snehaprasad11/SignSense/PROJECT_REPORT.pdf

# SignSense: Real-Time Sign Language Word Recognition on an ESP32 Using a Single IMU and TinyML

A wearable that recognises six sign-language words from hand motion and turns them into text and speech. One MPU6500/MPU6050 motion sensor sits on the back of the hand; an ESP32 microcontroller runs a 1-D convolutional neural network with TensorFlow Lite Micro, entirely on the device.

Words: HELLO · THANK YOU · YES · PLEASE · HELP · COME (+ rest)

Result | Value
Accuracy on held-out recordings | 94.92 % (224 / 236 windows)
Accuracy in live use on the ESP32 | 80.77 % (42 / 52 prompted trials)
On-device inference time | 279 ms per Invoke()
Model size | 437 KB float32 · 120 KB INT8 (same accuracy)
Hardware | ESP32-D0WD-V3 (no PSRAM) + MPU6500

This report follows the review presentation outline; each section maps to one or more slides.

## 1. Motivation 1 slide

Most hearing people do not know sign language, so deaf and hard-of-hearing signers often depend on an interpreter for everyday conversations.
Camera-based translators need good lighting, a clear view of the hands, a powerful computer and a camera pointed at the user, which raises privacy concerns.
Sensor gloves avoid the camera but usually need many sensors (one per finger) and a PC. Goal: a low-cost wearable that recognises common sign words on a ₹-level microcontroller, without a camera, a cloud connection or a PC doing the recognition.

SignSense project report · page 1 of 20

## 2. Contemporary works — literature survey 2 slides

# | Work | Approach | Strength | Limitation for our goal

[1] Camgöz et al., CVPR | 2020 | Video + Transformer (continuous SL translation) | Full sentences, high accuracy | Needs camera and GPU
[2] Wu, Sun & Jafari, IEEE | JBHI 2016 | Wrist IMU + surface EMG, 80 ASL signs | Real-time, wearable | Two sensor types; classification on a PC
[3] Zhou et al., Nature | Electronics 2020 | Stretchable yarn strain sensors on each finger, sign-to-speech | 660 ASL hand gestures, wireless | Custom fabricated sensors; recognition on a phone or PC
[4] Wen et al., Nature | Communications 2021 | Triboelectric smart glove + deep learning | Words and sentences | Many custom sensors; off-device processing
[5] Ahmed et al., Sensors | 2018 (review) | Survey of sensory gloves 2007–2017 | Shows the field's reliance on multi-sensor gloves | Few low-cost, on-device systems
[6] Ordóñez & Roggen, | Sensors 2016 | CNN + LSTM on wearable IMU data | Shows CNNs learn motion features from raw IMU data | Activity recognition, not sign language; not embedded
[7] David et al., MLSys 2021 | (TF Lite Micro) | Inference framework for microcontrollers | Neural networks in kilobytes of RAM | Framework only
[8] Banbury et al., 2020 | (TinyML benchmarking) | Benchmarks for ML on microcontrollers | Shows latency/memory limits of MCU ML | Not a sign-language system
[9] techmiguel/gesture- | recognition (GitHub) | ESP32-S3 + MPU6050 + Conv1D, 5 direction gestures | Fully on-device; our starting code base | Directions only; needs PSRAM; no live-accuracy study

Research gap and objective 1 slide

Gap

1. Camera systems need a camera, a GPU and a clear line of sight.
2. Glove systems use many sensors (one per finger) and send data to a PC or phone for recognition.
3. Few systems recognise sign words with one IMU and do the recognition entirely on a low-cost microcontroller, especially one without external PSRAM.
4. Most papers report only offline test accuracy. They rarely measure how accuracy changes when a person signs live, on prompt.

Objectives

1. Recognise 6 sign words + rest from a single back-of-hand IMU.
2. Run the complete model on a classic ESP32 (no PSRAM) with TensorFlow Lite Micro.
3. Reach ≥ 90 % accuracy on held-out data and measure live accuracy separately.
4. Measure on-device latency and memory, and compare float32 vs INT8 and Flatten vs GAP models.
5. Show the recognised word as text and speech on a laptop.

## 3. Proposed methodology — block diagram 1 slide

System block diagram (what runs at demo time)

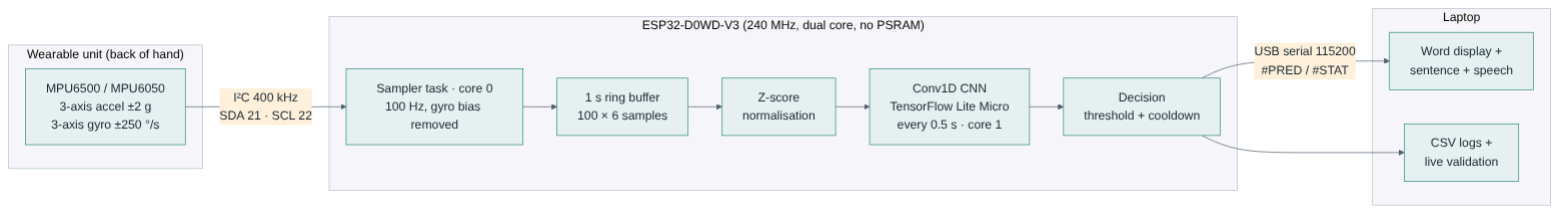
[picture p9: figure]

Development workflow (how the model was built; numbers = team roles, Section 11)

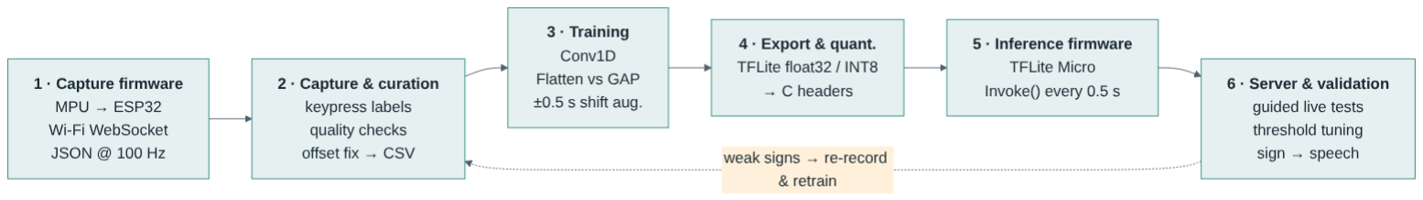
[picture p10: figure]

The dotted arrow shows the iteration loop used in this project: live testing found weak signs, which were re-recorded and retrained.

### 4. Sub-systems 1 slide, headings only

1. Sensing & capture firmware: MPU6500 driver, 100 Hz sampling, Wi-Fi streaming
2. Data capture & dataset curation: labelling, quality checks, offset correction, balancing
3. Model training: Conv1D network, augmentation, architecture comparison
4. Model export & quantization: TFLite float32 / INT8, C-array generation
5. On-device inference firmware: TFLite Micro, dual-core scheduling, decision logic
6. Inference server & system validation: live display, speech, guided tests, threshold tuning

Supporting diagrams:

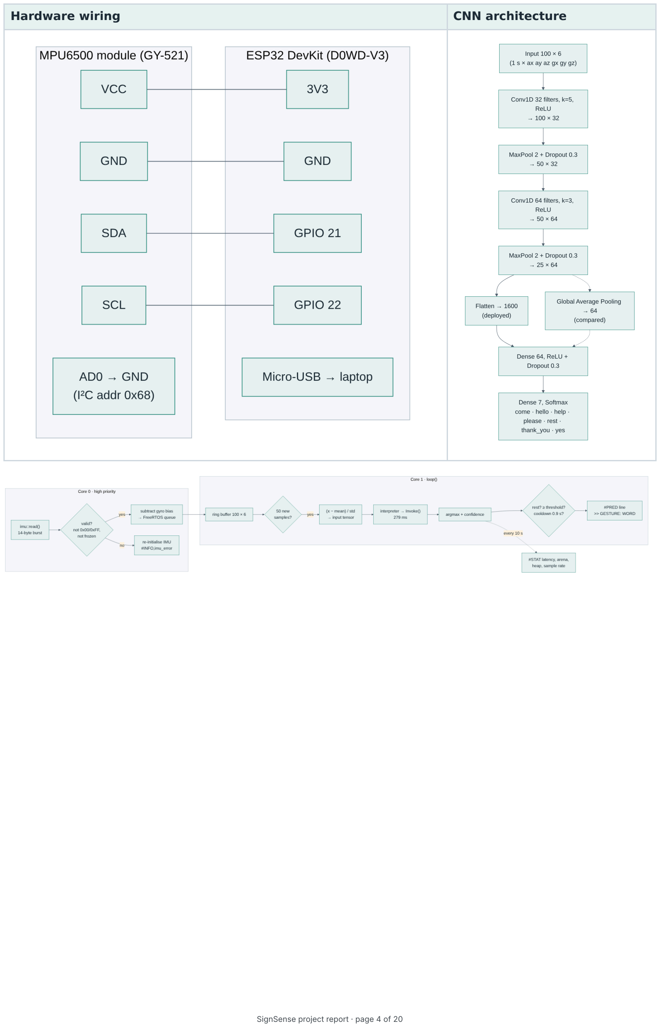
[picture p11: page 4]

Hardware wiring | CNN architecture

## 5. Database and performance metrics 1 slide

Dataset (self-recorded)

Item | Value
Sensor | MPU6500 (WHO_AM_I = 0x70), back of right hand
Channels | ax, ay, az (g, ±2 g) · gx, gy, gz (°/s, ±250 °/s)
Sampling | 100 Hz, digital low-pass ≈ 42 Hz
Sample (window) | 1 s = 100 timesteps × 6 axes = 600 values
Labelling | key press right after each sign; 3 time-shifted windows per press in the final round
Quality checks | Wi-Fi gaps, timing, saturation, "sign with no motion", "rest that moves", gyro offset
Classes | come, hello, help, please, rest, thank_you, yes
Clean windows | come 150 · hello 149 · help 191 · please 149 · rest 157 · thank_you 191 · yes 191 = 1,178
Split (stratified, seed 42) | train 800 · validation 142 · test 236
Training set after augmentation | 5,600 (6 extra copies: ±0.5 s time shift, noise, ±10 % scale)
Earlier dataset (direction gestures) | up / down / left / right / rest, 730 windows

Performance metrics

Metric | Formula
Accuracy | Σ TP / N
Precision | TP / (TP + FP)
Recall | TP / (TP + FN)
F1 score | 2PR / (P + R)
Cohen's κ | (p_o − p_e) / (1 − p_e)
95 % CI | Wilson score interval
Live trial accuracy | correct trials / prompted trials (guided test)
Latency, memory | measured on device: Invoke() µs, tensor-arena bytes, free heap

## 6. Results 3 slides

Results 1: Classification accuracy

| Test set (N = 236 windows) | Live on ESP32 (N = 52 trials)
Accuracy | 94.92 % (95 % CI 91.3–97.1) | 80.77 % (95 % CI 68.1–89.2)
Macro F1 | 95.11 % | 80.02 %
Cohen's κ | 0.941 | 0.776
Chance level | 14.3 % | 14.3 %

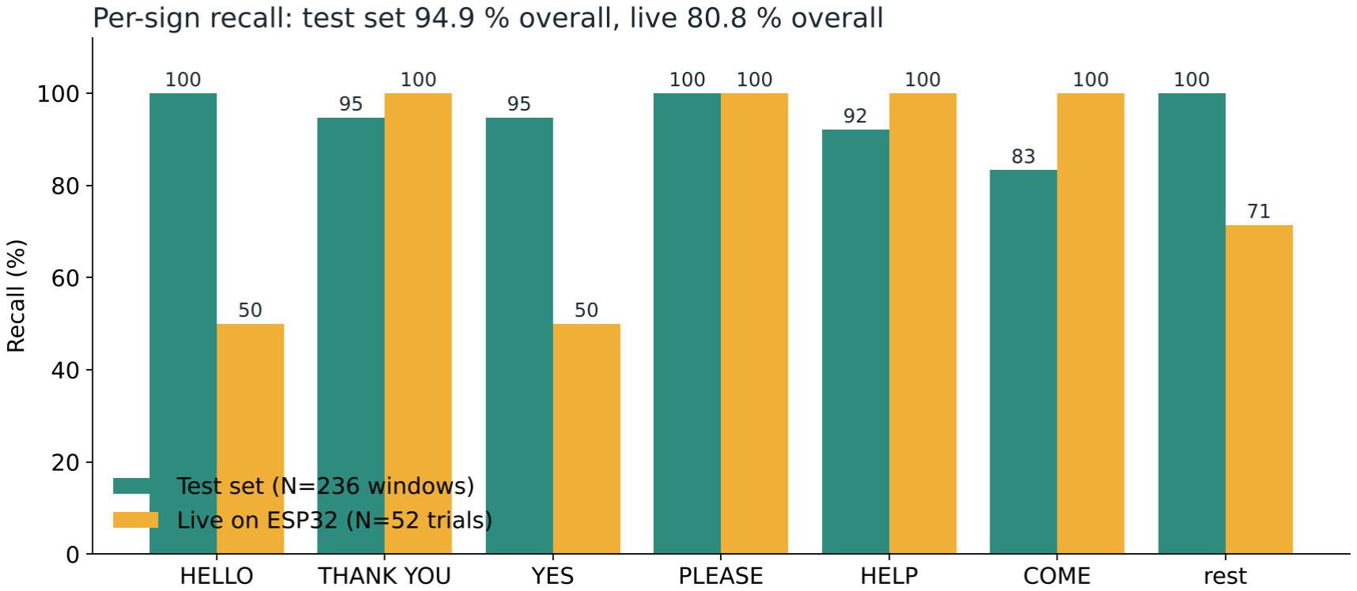
[picture p12: figure]

Test-set confusion matrix (rows = true, columns = predicted):

| come | hello | help | please | rest | thank_you | yes
come | 25 | 0 | 0 | 0 | 0 | 0 | 5
hello | 0 | 30 | 0 | 0 | 0 | 0 | 0
help | 0 | 0 | 35 | 0 | 0 | 2 | 1
please | 0 | 0 | 0 | 30 | 0 | 0 | 0
rest | 0 | 0 | 0 | 0 | 32 | 0 | 0
thank_you | 0 | 0 | 2 | 0 | 0 | 36 | 0
yes | 2 | 0 | 0 | 0 | 0 | 0 | 36

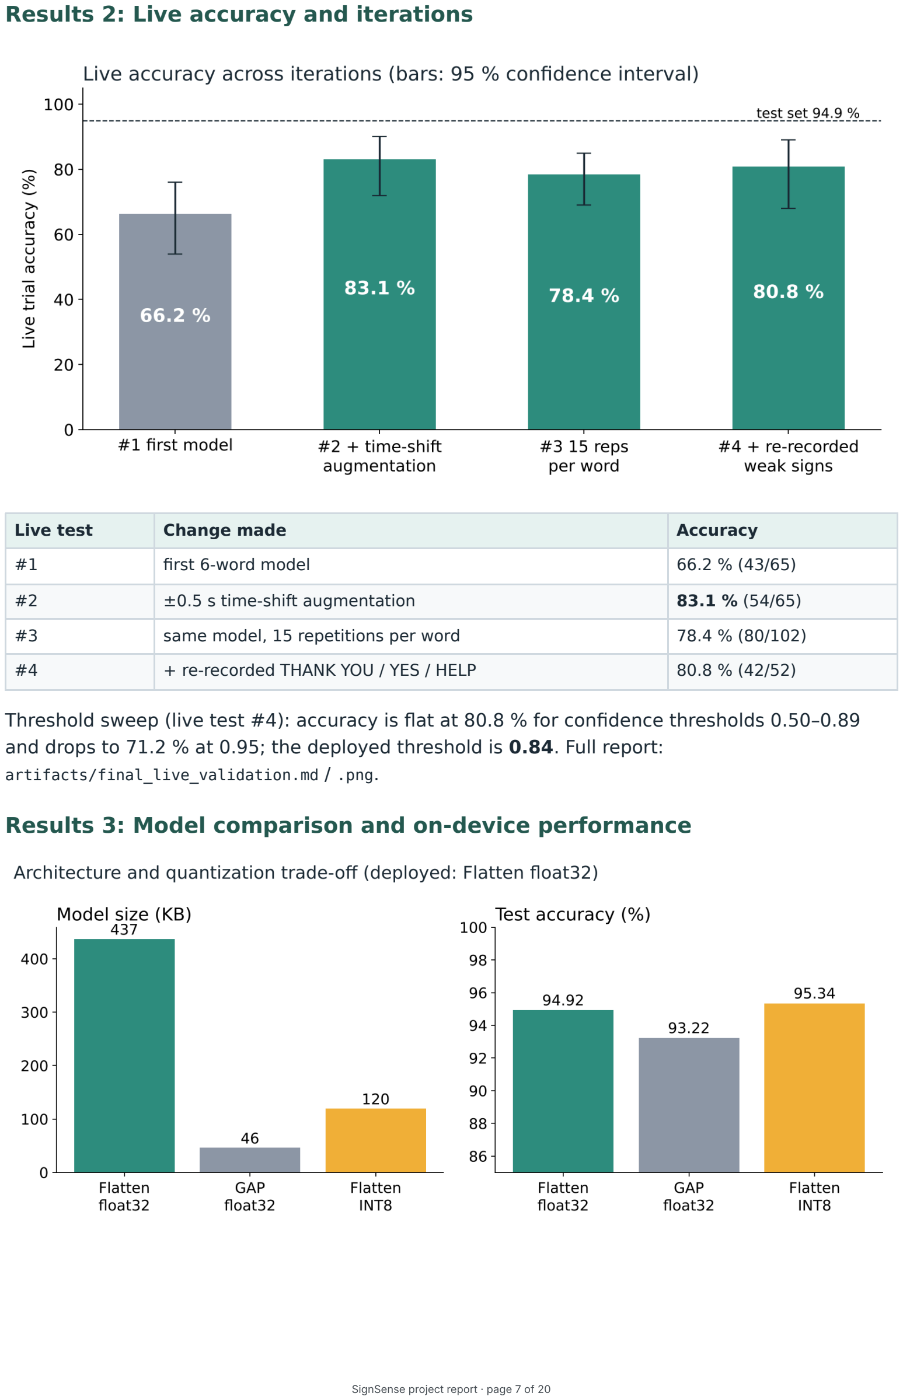
[picture p13: page 7]

Results 2: Live accuracy and iterations

Live test | Change made | Accuracy
#1 | first 6-word model | 66.2 % (43/65)

#2 | ±0.5 s time-shift augmentation | 83.1 % (54/65)

#3 | same model, 15 repetitions per word | 78.4 % (80/102)

#4 | + re-recorded THANK YOU / YES / HELP | 80.8 % (42/52)

Threshold sweep (live test #4): accuracy is flat at 80.8 % for confidence thresholds 0.50–0.89 and drops to 71.2 % at 0.95; the deployed threshold is 0.84. Full report:
artifacts/final_live_validation.md / .png.

Results 3: Model comparison and on-device performance

Model | Test accuracy | Parameters | Size
Conv1D + Flatten, float32 (deployed) | 94.92 % | 110,119 | 437.1 KB
Conv1D + Global Average Pooling | 93.22 % | 11,815 | 46.2 KB
Conv1D + Flatten, INT8 | 95.34 % (99.58 % agreement with float32) | 110,119 | 119.6 KB
On-device (ESP32-D0WD-V3, 240 MHz) | Value
Invoke() latency | 279.1 ms (min 279.08 · max 279.25)
Pre-processing | 0.22 ms
CPU load at 1 inference / 0.5 s | 55.8 % of one core
Sampling | 99.9 Hz, 0 samples lost
Tensor arena | 28 KB (internal RAM, no PSRAM)
Free heap at runtime | 186 KB
Flash used | 856 KB (27 %)
End of sign → word shown | ≈ 0.28–0.78 s

## 7. Discussion 1 slide

Offline vs live gap (94.9 % → 80.8 %). The test set comes from the same recording sessions as training. Live signs vary more in speed, size and timing. The largest single improvement, 66 % → 83 %, came from time-shift augmentation. In the recordings every sign ended at the window's end, but the device classifies every 0.5 s, so live signs appear anywhere in the window.
Weak signs. YES (a small fist nod) starts like COME and THANK YOU. HELLO (a repeated wave) can look like PLEASE's circular motion. With one sensor these differ only in small motion details. Signs with large, distinct movements (COME, HELP, PLEASE, THANK YOU) reach 100 % live.
Flatten vs GAP. GAP was better for direction gestures (99.3 % vs 98.0 %) but worse for signs (93.2 % vs 94.9 %). Averaging over time throws away when motion happens, and that timing is what separates COME from YES.
INT8 quantization cut size 3.65× with no accuracy loss. This leaves room for more classes or a larger model on the same chip.
Hardware findings. The "MPU6050" module was an MPU6500 clone (WHO_AM_I 0x70) and was rejected by the standard library, so a register-level driver was written. A gyro calibration taken while the board was moving shifted the first dataset by ≈ 50 °/s. Curation now detects and removes this, and the firmware refuses to calibrate while moving.
Threshold. Higher thresholds cut false triggers but miss weak signs; 0.84 balanced both.

## 8. Novelty and future scope 1 slide

Novelty

1. Sign-word recognition with one IMU and the complete CNN running on a classic ESP32 without PSRAM (28 KB tensor arena in internal RAM).

2. Live, prompted validation with per-iteration accuracy, confidence intervals and a threshold sweep, in addition to offline accuracy.
3. Time-shift augmentation matched to the inference stride, which raised live accuracy from 66 % to 83 % without new recordings.
4. Robust low-cost hardware handling: clone-sensor driver, motion-gated gyro calibration, automatic offset correction, and recovery from a loose sensor wire without a reboot.
5. Fully reproducible pipeline: model_config.h (normalisation, classes, quantization) is generated automatically, so the firmware and the training code always match.

Future scope

Record training data in the same prompted way as live use, aiming for ≥ 90 % live accuracy. Add finger flex sensors to recognise handshapes and the alphabet.
Deploy the INT8 model with ESP-NN optimised kernels to cut latency below 100 ms. Bluetooth Low Energy output to a phone app instead of a USB cable.
More signers and more words; continuous sentence recognition with a sequence model. Browser dashboard (live word, sentence, confidences, device health).

## 9. Conclusion 1 slide

A single-IMU wearable with an ESP32 recognises six sign words plus rest entirely on the device: 94.9 % accuracy on held-out data, 80.8 % in live prompted use, and 279 ms inference using 28 KB of RAM on a microcontroller without PSRAM. Time-shift augmentation was the key step for real-world use. Signs with distinct movements are recognised reliably, while signs with very small motions (YES, HELLO) need more training data recorded under live conditions, or additional sensors.

## 10. References 1 slide

1. N. C. Camgöz, O. Koller, S. Hadfield, R. Bowden, "Sign Language Transformers: Joint End-to-End Sign Language Recognition and Translation," Proc. IEEE/CVF CVPR, 2020.
2. J. Wu, L. Sun, R. Jafari, "A Wearable System for Recognizing American Sign Language in Real-Time Using IMU and Surface EMG Sensors," IEEE J. Biomed. Health Inform., vol. 20, no. 5, 2016.
3. Z. Zhou et al., "Sign-to-speech translation using machine-learning-assisted stretchable sensor arrays," Nature Electronics, vol. 3, 2020.
4. F. Wen, Z. Zhang, T. He, C. Lee, "AI enabled sign language recognition and VR space bidirectional communication using triboelectric smart glove," Nature Communications, vol. 12, 2021.
5. M. A. Ahmed, B. B. Zaidan, A. A. Zaidan, M. M. Salih, M. M. Lakulu, "A Review on Systems-Based Sensory Gloves for Sign Language Recognition State of the Art between 2007 and 2017," Sensors, vol. 18, no. 7, 2018.
6. F. J. Ordóñez, D. Roggen, "Deep Convolutional and LSTM Recurrent Neural Networks for Multimodal Wearable Activity Recognition," Sensors, vol. 16, no. 1, 2016.
7. R. David et al., "TensorFlow Lite Micro: Embedded Machine Learning for TinyML Systems," Proc. MLSys, 2021.
8. C. Banbury et al., "Benchmarking TinyML Systems: Challenges and Direction," arXiv:2003.04821, 2020.
9. B. Jacob et al., "Quantization and Training of Neural Networks for Efficient Integer-Arithmetic-Only Inference," Proc. IEEE/CVF CVPR, 2018.
10. M. Lin, Q. Chen, S. Yan, "Network In Network," Proc. ICLR, 2014 (global average pooling).
11. P. Warden, D. Situnayake, TinyML, O'Reilly Media, 2019.
12. techmiguel, "gesture-recognition: ESP32-S3 + MPU6050 + TFLite Micro," GitHub repository, https://github.com/techmiguel/gesture-recognition.
13. InvenSense, MPU-6500 Product Specification and Register Map, rev. 1.x.

## 11. Individual roles 1 slide

# | Sub-system / files | Member | Key contribution (one line for the slide)

1 | Capture firmware: esp32s3_capture.ino, imu.h | Nitigya Khaneja | Register-level MPU6500 driver, 100 Hz fixed-rate sampling, JSON over Wi-Fi WebSocket, motion-gated gyro calibration
2 | Data capture & curation: capture_server.py, curate_dataset.py | Yashita Shrivastava | 1,178 labelled windows (7 classes); automatic quality checks, gyro-offset correction and balancing
3 | Model training: train.py | Sneha Prasad | Conv1D pipeline, Flatten vs GAP comparison, ±0.5 s time-shift augmentation → 94.9 % test accuracy
4 | Export & quantization: export_model.py | Arshiya Agarwal | Float32 (437 KB) and INT8 (120 KB, 95.3 %) TFLite models; auto-generated C headers
5 | Inference firmware: esp32s3_inference.ino | Anusha Ghose | TFLite Micro on a no-PSRAM ESP32 (28 KB arena), dual-core sampling, library fixes, Invoke() = 279 ms
6 | Inference server & validation: inference_server.py, analyze_live.py | Abhilash Sarma | Sign → text/speech, guided live tests, confusion analysis, threshold tuning (0.84) → 80.8 % live

How the six roles connect:

Nitigya | Yashita | Sneha | Arshiya | Anusha | Abhilash
Capture | ──► Capture & | ──► Model | ──► Export & | ──► Inference | ──► Inference server
firmware | curation | training | quantization | firmware | & validation
(sensor → | (labelled, | (Conv1D, | (TFLite, | (TFLite Micro | (words, speech,
Wi-Fi JSON) | clean CSVs) | reports) | C headers) | on ESP32) | live accuracy)
▲ | │
└──────────────── live testing found weak signs → re-record → retrain ───────────────┘

Changes from the original plan (role slide). The plan assumed an ESP32-S3 with PSRAM, 5 direction gestures and a fixed 0.90 threshold. The team's board is a classic ESP32 (ESP32-D0WD-V3) without PSRAM, the sensor is an MPU6500 clone, and the final system recognises 6 sign words + rest, with the threshold tuned to 0.84 from live tests. The descriptions below reflect what was actually built. An updated slide text is at the end.

### 11.1. Capture firmware: Nitigya Khaneja

Files: firmware/esp32s3_capture/esp32s3_capture.ino, imu.h, secrets.h.template

Job: read the motion sensor at exactly 100 Hz and stream every sample to the laptop for recording.

MPU6500 ──I²C 400 kHz──► ESP32 ──fixed 10 ms schedule──► JSON ──Wi-Fi WebSocket :8765──► laptop
SDA 21 / SCL 22 | (gyro bias removed) | {"seq","timestamp_us","ax".."gz","temp_c"}

What was built

Register-level IMU driver (imu.h). The module sold as an "MPU6050" is actually an MPU6500 (WHO_AM_I = 0x70 instead of 0x68), and the standard library rejected it. The driver accepts the MPU6050/6500/9250 family and configures each one identically: ±2 g, ±250 °/s, ≈ 42 Hz low-pass, plus the extra accelerometer filter register that only the 6500 has.
Pins for the classic ESP32. GPIO 8/9 (from the ESP32-S3 plan) are flash pins on this chip; moved to GPIO 21/22 with automatic selection by chip type.
Fixed-rate 100 Hz sampling with micros() scheduling that never drifts and resyncs if late. A sequence number lets the server detect lost samples.
Motion-gated gyro calibration. At boot the zero-rate offset (≈ 7 °/s on this sensor) is measured and subtracted. Calibration is refused while the sensor moves. This was added after a moving calibration shifted a whole dataset by ≈ 50 °/s.
Wi-Fi/WebSocket robustness: auto-reconnect, heartbeat, Wi-Fi sleep disabled for low latency, and [STATS] output (rate, dropped, RSSI) every 5 s.
Connection debugging solved: a port number typed into the IP field, the Windows firewall on public networks, and the 2.4 GHz hotspot requirement.
Sensor-loss recovery: detects missing, all-0xFF or frozen data and re-initialises the sensor instead of halting.

Result: stable 100 Hz streams with 0 gaps across all recording sessions.

### 11.2. Data capture & dataset curation: Yashita Shrivastava

Files: python/capture_server.py, python/curate_dataset.py, data/

Job: turn the live stream into a clean, labelled, balanced dataset.

JSON stream ─► ring buffer (last 1 s) ─► key press ─► quality check ─► data_<word>.csv
1-6 / space ✓ save / ✗ reject │

data_*.csv ─► drop bad rows ─► drop duplicates ─► fix gyro offset ─► drop outliers ─► data/clean/

What was built

Labelling by key press: 1 = HELLO, 2 = THANK YOU, 3 = YES, 4 = PLEASE, 5 = HELP, 6 = COME, space = rest; r auto-records rest, z undoes. Keys are generated from the class list, so any word set works.
Automatic quality checks on every window: missing samples (Wi-Fi drops), wrong timing, sensor saturation, "sign with no motion" (key pressed too late), "rest that moves", and a gyro offset during rest (bad calibration).
Multi-alignment capture: each key press saves 3 windows, ending 0, 0.25 and 0.5 s after the press, so the sign appears at different positions, as it does in live use.
Curation (curate_dataset.py): removes malformed rows, duplicates and motion-energy outliers. It also detects and removes a constant gyro offset: the first recording session had −24 / +47 / +23 °/s on the gyro axes because the board was moving during calibration, and that data was rescued instead of re-recorded. It writes a per-class mean-signal plot
(artifacts/dataset_report.png).

Result: 1,178 clean windows across 7 classes (149–191 per class), plus a 730-window direction-gesture dataset from the first phase.

### 11.3. Model training: Sneha Prasad

Files: python/train.py, artifacts/training_report.png, artifacts/arch_comparison.md

Job: design and train the neural network and compare alternatives.

What was built

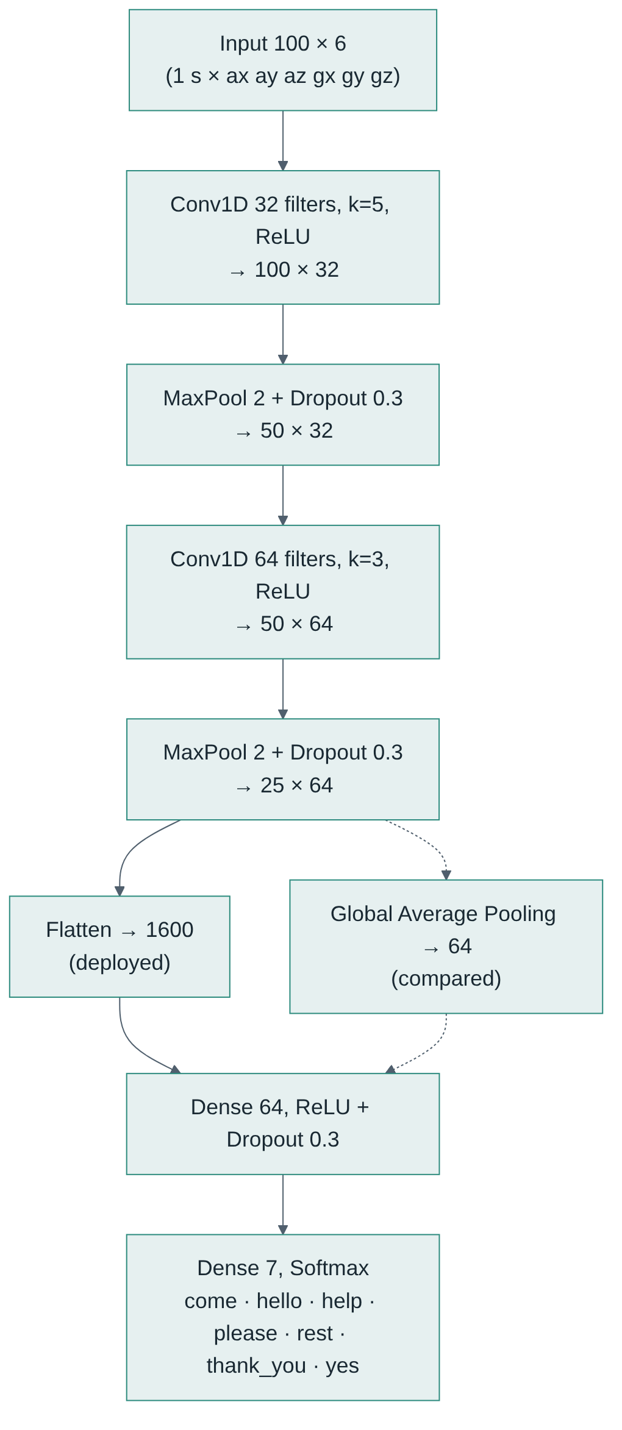
[picture p14: figure]

Conv1D network: two convolution blocks (32 and 64 filters) slide along time, learning motion shapes such as the onset, peak and stop of a sign, independent of where they occur. Per-axis Z-score normalisation computed on the training split only, so nothing leaks from the test set.
Stratified 20 % test split, a 15 % validation split, early stopping (patience 12) and learningrate reduction.
Flatten vs Global Average Pooling comparison (the trade-off planned for this role):
| Flatten | GAP
Parameters | 110,119 | 11,815 (9.3× fewer)
Sign words, test accuracy | 94.92 % | 93.22 %
Direction gestures, test accuracy | 97.95 % | 99.32 %

GAP is better for simple directions but loses the timing information that separates COME from YES, so Flatten is deployed for signs. - Time-shift augmentation (key improvement): ±0.5 s shifts, noise and ±10 % scaling. With a 0.5 s shift, accuracy rose from 78.5 % to 90.3 %, and live accuracy from 66 % to 83 %.

Result: 94.92 % test accuracy, macro F1 95.11 %, κ = 0.941.

### 11.4. Model export & quantization: Arshiya Agarwal

Files: python/export_model.py, artifacts/quantization_report.md, firmware/esp32s3_inference/gesture_model.h, model_config.h

Job: convert the trained model into something the microcontroller can run, and test quantization.

gesture_model.keras ─┬─► TFLite float32 (437.1 KB) ─┐
└─► TFLite INT8 (119.6 KB) ─┴─► accuracy / agreement / size report └─► gesture_model.h (C byte array, 16-byte aligned) model_config.h (classes, NORM_MEAN/STD, quant scale & zero point)

What was built

Float32 and full-integer INT8 export. INT8 is calibrated on 300 real training windows, with int8 input and output tensors.
Automatic comparison: each .tflite file is run on the test set and compared with the Keras model.
| Float32 | INT8
Size | 437.1 KB | 119.6 KB (3.65× smaller)
Test accuracy | 94.92 % | 95.34 %
Agreement with float32 | — | 99.58 %

Auto-generated firmware headers. model_config.h holds the class names, normalisation values, quantization parameters and the list of operators. This removed the error-prone step of copying numbers into firmware by hand. The firmware supports both models through
MODEL_IS_INT8.

Result: INT8 cuts model size by 73 % with no accuracy loss; float32 is deployed.

### 11.5. Inference firmware: Anusha Ghose

Files: firmware/esp32s3_inference/esp32s3_inference.ino, imu.h; patches to the TensorFlowLite_ESP32 Arduino library

Job: run the model on the ESP32 in real time and report predictions and performance.

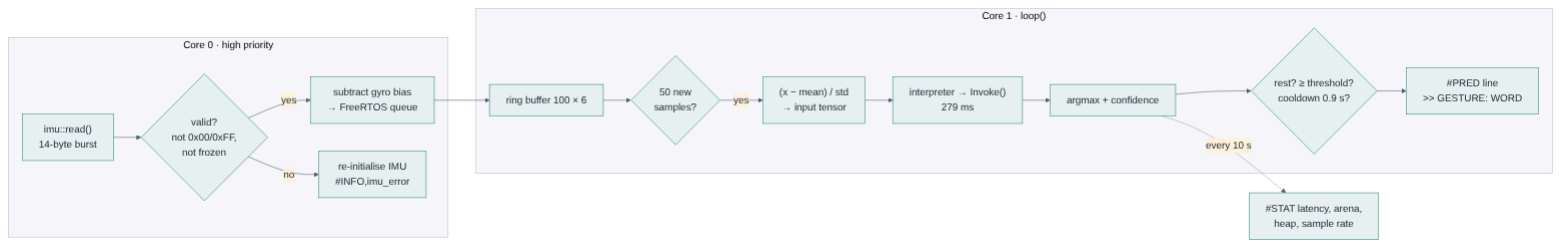
[picture p15: figure]

What was built

Ported from ESP32-S3 + PSRAM to a classic ESP32 without PSRAM. The tensor arena is allocated in internal RAM (PSRAM is used automatically if present). Measured usage is 28 KB, with 186 KB heap free.
Dual-core design. A FreeRTOS sampler task on core 0 reads the sensor every 10 ms. Inference runs on core 1, so the 279 ms Invoke() never delays sampling: 99.9 Hz with 0 lost samples.

### 1 s ring buffer with 50 % overlap: a prediction every 0.5 s, so a sign is never split

between two non-overlapping windows.
Pre-processing with normalisation constants from model_config.h; float32 or int8 input path chosen at compile time.

Decision logic: confidence threshold (changeable at runtime with t 0.84), a 0.9 s cooldown so one sign is reported once, and rest suppression.
Fixed inference issues:
Three compile failures from the 2022 TFLite library with the newer ESP32 core 3.x: a const flatbuffers member, unused LCD/camera drivers, and a private operator delete. All were patched, with the originals backed up.
Frozen predictions from a loose sensor wire: the firmware now detects bad data (0x00/0xFF or frozen) and re-initialises the sensor, rather than feeding garbage to the model. Model/firmware mismatch protection: input and output tensor size and type are checked at boot.
Measured Invoke() latency. #STAT lines report average/min/max latency, pre-processing time, arena, heap and sample rate every 10 s. Serial commands: t threshold, c recalibrate, s stats, w window diagnostics.

Result: Invoke() = 279.1 ms (±0.1 ms), pre-processing 0.22 ms, 55.8 % of one core, flash 856 KB (27 %). The word is shown 0.28–0.78 s after the sign ends.

### 11.6. Inference server & system validation: Abhilash Sarma

Files: python/inference_server.py, python/analyze_live.py, artifacts/*live_validation*

Job: show the result to the user, and measure how well the full system works in real use.

ESP32 serial ─► parse #PRED/#STAT ─┬─► big word + sentence + speech (pyttsx3)
├─► CSV log (every window, latency)
└─► guided test: "get ready: YES (fist nodding)… GO!"
└─► analyze_live.py → confusion matrix, threshold sweep, latency histogram, recommended threshold

What was built

Serial inference monitor with confidence bars for all 7 classes and CSV logging.
Sign → text and speech: each accepted sign is shown as a large word and spoken aloud; words within 6 s build a sentence ("HELLO HELP PLEASE").
Guided live test: random prompts with a reminder of how to sign each word; every prediction is labelled with the expected word.
Live analysis: trial-level confusion matrix, most frequent confusions, and a threshold sweep from 0.50 to 0.99 covering accuracy, missed signs, wrong class and false triggers.
Threshold tuning: 0.90 (plan) → 0.95 (test #2, removed false triggers) → 0.84 (test #4: best accuracy and fewer missed signs).
Found the offline–live gap and its causes: sign timing, which led to the augmentation fix, and YES/THANK YOU, which led to re-recording. Four live test rounds:
Test | Accuracy
#1 | 66.2 %

#2 | 83.1 %

#3 | 78.4 %

#4 (final) | 80.8 %

Result: 80.8 % live accuracy (κ = 0.776). COME, HELP, PLEASE and THANK YOU reach 100 % live; YES and HELLO are the remaining weak signs.

### 11.7 Updated text for the "Individual role" slide

### 1. Capture Firmware (esp32s3_capture.ino, imu.h): Nitigya Khaneja Wrote a register-level

driver for the MPU6500 clone, wired it to the ESP32 via I²C (GPIO 21/22), implemented drift-free 100 Hz sampling with motion-gated gyro calibration, and streamed JSON over a Wi-Fi WebSocket. Debugged Wi-Fi, firewall and sensor-connection issues.

### 2. Data Capture & Dataset Curation (capture_server.py, curate_dataset.py): Yashita

Shrivastava Captured all 7 classes (6 sign words + rest) with keypress labelling and automatic quality checks, and corrected a gyro-offset error in the first dataset. Produced 1,178 clean windows (149–191 per class).

### 3. Model Training (train.py): Sneha Prasad Developed the Conv1D training pipeline and

compared Flatten vs Global Average Pooling (94.9 % vs 93.2 %, 9× fewer parameters). Added ±0.5 s time-shift augmentation, which raised live accuracy from 66 % to 83 %.

### 4. Model Export & Quantization (export_model.py): Arshiya Agarwal Exported to TFLite and

C-array format with auto-generated config headers. INT8 quantization: 119.6 KB vs the 437 KB float32 model (3.65× smaller) at 95.3 % accuracy (no loss).

### 5. Inference Firmware (esp32s3_inference.ino): Anusha Ghose Deployed the model on a

classic ESP32 without PSRAM (28 KB tensor arena in internal RAM) with dual-core sampling and inference. Patched the TFLite library for ESP32 core 3.x, fixed sensor dropouts, and measured Invoke() latency: 279 ms.

### 6. Inference Server & System Validation (inference_server.py, analyze_live.py): Abhilash

Sarma Handled serial inference, word display, speech and CSV logging. Ran guided live tests, analysed gesture confusion, and tuned the confidence threshold to 0.84, for a final live accuracy of 80.8 %.

## Appendix A: Detailed accuracy calculations

A.1. Formulas

Confusion matrix: rows = true class, columns = predicted class.

Metric | Formula
Accuracy | Σ TP / N (correct predictions ÷ all predictions)
Precision (class c) | TP / (TP + FP) = diagonal ÷ column sum
Recall (class c) | TP / (TP + FN) = diagonal ÷ row sum
F1 (class c) | 2 · P · R / (P + R)
Macro average | mean of a metric over the 7 classes
Cohen's κ | (p_o − p_e) / (1 − p_e), p_o = accuracy, p_e = Σ(row total × column total) / N²
95 % confidence interval | Wilson score interval for k correct out of n
Chance level | 1 / 7 classes = 14.3 %

Worked example (COME, test set): the model predicted COME 27 times, 25 correctly (2 were YES) → P = 25/27 = 92.59 %. There are 30 real COME windows, 25 found → R = 25/30 = 83.33 %. F1 = 2(0.9259 × 0.8333)/(0.9259 + 0.8333) = 87.72 %.

A.2. Final model — test set (N = 236 windows)

Accuracy = 224 / 236 = 94.92 % (95 % CI 91.3–97.1 %) · macro precision 95.38 % · macro recall 94.99 % · macro F1 95.11 % · κ = 0.941

Class | TP / support | Precision | Recall | F1
COME | 25 / 30 | 92.59 % | 83.33 % | 87.72 %
HELLO | 30 / 30 | 100 % | 100 % | 100 %
HELP | 35 / 38 | 94.59 % | 92.11 % | 93.33 %
PLEASE | 30 / 30 | 100 % | 100 % | 100 %
rest | 32 / 32 | 100 % | 100 % | 100 %
THANK YOU | 36 / 38 | 94.74 % | 94.74 % | 94.74 %
YES | 36 / 38 | 85.71 % | 94.74 % | 90.00 %

Confusion matrix (rows = true, columns = predicted):

true \ pred | come | hello | help | please | rest | thank_you | yes
come | 25 | 0 | 0 | 0 | 0 | 0 | 5
hello | 0 | 30 | 0 | 0 | 0 | 0 | 0
help | 0 | 0 | 35 | 0 | 0 | 2 | 1
please | 0 | 0 | 0 | 30 | 0 | 0 | 0
rest | 0 | 0 | 0 | 0 | 32 | 0 | 0
thank_you | 0 | 0 | 2 | 0 | 0 | 36 | 0
yes | 2 | 0 | 0 | 0 | 0 | 0 | 36

Main confusion: COME → YES (5×).

A.3. Live on the ESP32 — final test (N = 52 trials, threshold 0.84)

Accuracy = 42 / 52 = 80.77 % (95 % CI 68.1–89.2 %) · macro precision 83.65 % · macro recall 81.63 % · macro F1 80.02 % · κ = 0.776

Class | Correct / trials | Precision | Recall | F1
COME | 7 / 7 | 77.78 % | 100 % | 87.50 %
HELLO | 4 / 8 | 100 % | 50.00 % | 66.67 %
HELP | 7 / 7 | 77.78 % | 100 % | 87.50 %
PLEASE | 8 / 8 | 66.67 % | 100 % | 80.00 %
rest | 5 / 7 | 83.33 % | 71.43 % | 76.92 %
THANK YOU | 7 / 7 | 100 % | 100 % | 100 %
YES | 4 / 8 | 80.00 % | 50.00 % | 61.54 %
true \ pred | come | hello | help | please | rest | thank_you | yes
come | 7 | 0 | 0 | 0 | 0 | 0 | 0
hello | 0 | 4 | 1 | 3 | 0 | 0 | 0
help | 0 | 0 | 7 | 0 | 0 | 0 | 0
please | 0 | 0 | 0 | 8 | 0 | 0 | 0
rest | 0 | 0 | 0 | 1 | 5 | 0 | 1
thank_you | 0 | 0 | 0 | 0 | 0 | 7 | 0
yes | 2 | 0 | 1 | 0 | 1 | 0 | 4

Main confusions: HELLO → PLEASE (3×), YES → COME (2×).

A.4. Live accuracy across iterations

Live test | Change made | Accuracy | 95 % CI
#1 | first 6-word model | 66.2 % (43/65) | 54–76 %

#2 | ±0.5 s time-shift augmentation | 83.1 % (54/65) | 72–90 %

#3 | same model, 15 repetitions per word | 78.4 % (80/102) | 69–85 %

#4 | + extra THANK YOU / YES / HELP recordings | 80.8 % (42/52) | 68–89 %

The confidence intervals of #2–#4 overlap, so they are statistically about the same (~80 %). The significant improvement was #1 → #2: recordings always had the sign at the end of the window, while live windows (0.5 s stride) see it at any position. Augmenting training data with ±0.5 s time shifts fixed this (test accuracy with a 0.5 s shift: 78.5 % → 90.3 %).

## Appendix B: project structure and how to run

gesture_project/
├── firmware/
│ | ├── esp32s3_capture/ | esp32s3_capture.ino, imu.h, secrets.h(.template)
│ | └── esp32s3_inference/ | esp32s3_inference.ino, imu.h, gesture_model.h*, model_config.h*
├── python/
│ | ├── config.py | classes, words, window size, threshold (shared by all scripts)
│ | ├── capture_server.py | record labelled windows over WebSocket
│ | ├── curate_dataset.py | clean, fix offset, balance → data/clean/
│ | ├── train.py | train Conv1D (Flatten / GAP), reports
│ | ├── export_model.py | TFLite float32 + INT8, generates *.h files
│ | ├── inference_server.py | live words + speech, guided test (--test)
│ | ├── analyze_live.py | live confusion matrix, threshold sweep, latency
│ | └── simulate_esp32.py | test the software without hardware
├── data/ | recorded CSVs (data_<class>.csv)
├── artifacts/ | trained models and reports
├── logs/ | live-test and device-stat logs
├── docs/diagrams/ | block diagrams and result charts (PNG + Mermaid source)
└── PROJECT_REPORT.md | this document (also as PDF)

* generated by export_model.py.

Hardware: MPU6500 VCC→3V3, GND→GND, SDA→GPIO 21, SCL→GPIO 22. Arduino IDE board "ESP32 Dev Module", Partition "Huge APP", PSRAM disabled, upload speed 115200. Libraries: WebSockets (Markus Sattler), TensorFlowLite_ESP32 (patched for ESP32 core 3.x; see Section 11.5).

pip install -r requirements.txt
cd python
python capture_server.py | # 1-6 = signs, space = rest, r = auto-rest, z = undo, q = quit
python curate_dataset.py --no-balance
python train.py --arch flatten --augment --aug-copies 6 --max-shift 50
python export_model.py | # then upload firmware/esp32s3_inference
python inference_server.py --speak --quiet --threshold 0.84 --port COM5
python inference_server.py --test --reps 8 --ready 2 --port COM5
python analyze_live.py ../logs/inference_test_*.csv --threshold 0.84
